zenitheesc/ZenSat-V3-EPS/README.md

<h1 align="center" style="color:white; background-color:black">ZenSat V3</h1>
<h4 align="center">Projeto de um CubeSat 2U para a competição Cube Design</h4>

<p align="center">
	<a href="http://zenith.eesc.usp.br/">
    
    </a>
    <a href="https://eesc.usp.br/">
    
    </a>
    <a href="https://github.com/${{ env.REPOSITORY_FULL_NAME }}/blob/main/LICENSE">
    
    </a>
    <a href="https://github.com/${{ env.REPOSITORY_FULL_NAME }}/issues">
    
    </a>
    <a href="https://github.com/${{ env.REPOSITORY_FULL_NAME }}/commits/main">
    
    </a>
    <a href="https://github.com/${{ env.REPOSITORY_FULL_NAME }}/graphs/contributors">
    
    </a>
    <a href="https://github.com/${{ env.REPOSITORY_FULL_NAME }}/commits/main">
    
    </a>
    <a href="https://github.com/${{ env.REPOSITORY_FULL_NAME }}/issues">
    
    </a>
    <a href="https://github.com/${{ env.REPOSITORY_FULL_NAME }}/pulls">
    
    </a>
</p>

<p align="center">
    <a href="#environment-and-tools">Environment and Tools</a> •
    <a href="#steps-to-run-and-debug">Steps to run and debug</a> •
    <a href="#how-to-contribute">How to contribute?</a> •
</p>

## Environment and tools

`Add list of dependencies and software needed to run this project (if possible add the versions that were used in development).`

## Steps to run and debug

`A simple list of steps indicating how one can run and test the project.`

## How to contribute

`(optional, depends on the project) list of simple rules to help people work on the project.`

`Examples: How to format a pull request\n How to format an issue`

---

<p align="center">
    <a href="http://zenith.eesc.usp.br">
    
    </a> 
    <a href="https://www.facebook.com/zenitheesc">
    
    </a> 
    <a href="https://www.instagram.com/zenith_eesc/">
    
    </a>

</p>
<p align = "center">
<a href="zenith.eesc@gmail.com">zenith.eesc@gmail.com</a>
</p>
