zenitheesc/ZenSat-V3-EPS/Main Board/BOM.csv

Reference | Qty | Value | DNP | Exclude from BOM | Exclude from Board | Footprint
C1,C2,C3,C4,C5,C6,C15,C22,C33 | 9 | 100nF |  |  |  | Capacitor_SMD:C_0402_1005Metric_Pad0.74x0.62mm_HandSolder
C7 | 1 | 1u |  |  |  | Capacitor_SMD:C_0402_1005Metric_Pad0.74x0.62mm_HandSolder
C10,C11 | 2 | 7p |  |  |  | Capacitor_SMD:C_0402_1005Metric_Pad0.74x0.62mm_HandSolder
C12,C14 | 2 | 33p |  |  |  | Capacitor_SMD:C_0402_1005Metric_Pad0.74x0.62mm_HandSolder
C13 | 1 | 4n7 |  |  |  | Capacitor_SMD:C_0402_1005Metric_Pad0.74x0.62mm_HandSolder
C16,C23,C37 | 3 | 10uF |  |  |  | Capacitor_SMD:C_0805_2012Metric_Pad1.18x1.45mm_HandSolder
C17,C18,C19,C20,C24,C25,C26,C27 | 8 | 22uF |  |  |  | Capacitor_SMD:C_1206_3216Metric_Pad1.33x1.80mm_HandSolder
C21,C28,C36 | 3 | 1uF |  |  |  | Capacitor_SMD:C_0603_1608Metric_Pad1.08x0.95mm_HandSolder
C29 | 1 | 100nF 25V |  |  |  | Capacitor_SMD:C_0402_1005Metric_Pad0.74x0.62mm_HandSolder
C30 | 1 | 10uF 10V |  |  |  | Capacitor_SMD:C_0805_2012Metric_Pad1.18x1.45mm_HandSolder
C31,C32,C34,C35 | 4 | 100nF 10V |  |  |  | Capacitor_SMD:C_0402_1005Metric_Pad0.74x0.62mm_HandSolder
C38 | 1 | 1uF 50V |  |  |  | Capacitor_SMD:C_0603_1608Metric_Pad1.08x0.95mm_HandSolder
C39 | 1 | 10uF 25V |  |  |  | Capacitor_SMD:C_1206_3216Metric_Pad1.33x1.80mm_HandSolder
C40 | 1 | 680nF |  |  |  | Capacitor_SMD:C_0402_1005Metric_Pad0.74x0.62mm_HandSolder
C41,C42 | 2 | 220nF |  |  |  | Capacitor_SMD:C_0402_1005Metric_Pad0.74x0.62mm_HandSolder
D1,D2,D3,D5,D6 | 5 | 1N5819HW |  |  |  | Diode_SMD:D_SOD-123
D4 | 1 | SS34 |  |  |  | Diode_SMD:D_SMA
D7,D8 | 2 | LEDG |  |  |  | LED_SMD:LED_0805_2012Metric_Pad1.15x1.40mm_HandSolder
D9 | 1 | LEDR |  |  |  | LED_SMD:LED_0805_2012Metric_Pad1.15x1.40mm_HandSolder
J1 | 1 | BatBus |  |  |  | Connector_PinHeader_2.54mm:PinHeader_2x06_P2.54mm_Vertical
J2 | 1 | ZenBus |  |  |  | Connector_PinHeader_2.54mm:PinHeader_2x20_P2.54mm_Vertical
J3 | 1 | Programmer |  |  |  | Connector_Molex:Molex_PicoBlade_53261-1071_1x10-1MP_P1.25mm_Horizontal
J4,J5,J6,J7 | 4 | Conn_01x02_Pin |  |  |  | Connector_JST:JST_ZH_B2B-ZR_1x02_P1.50mm_Vertical
J8 | 1 | External Power |  |  |  | Connector_Molex:Molex_PicoBlade_53261-0671_1x06-1MP_P1.25mm_Horizontal
JP1 | 1 | BOOT |  |  |  | Jumper:SolderJumper-3_P1.3mm_Open_RoundedPad1.0x1.5mm_NumberLabels
L1 | 1 | 6,8uH |  |  |  | Inductor_SMD:L_Sumida_CDMC6D28_7.25x6.5mm
L2 | 1 | 8uH |  |  |  | Inductor_SMD:L_Sumida_CDMC6D28_7.25x6.5mm
L3 | 1 | 47uH |  |  |  | Inductor_SMD:L_TDK_SLF7032
R1,R2,R4,R5,R10,R14,R19,R22,R23,R24,R25,R48,R51 | 13 | 10k |  |  |  | Resistor_SMD:R_0402_1005Metric_Pad0.72x0.64mm_HandSolder
R6,R7 | 2 | 4k7 |  |  |  | Resistor_SMD:R_0402_1005Metric_Pad0.72x0.64mm_HandSolder
R8,R9 | 2 | 60 |  |  |  | Resistor_SMD:R_0603_1608Metric_Pad0.98x0.95mm_HandSolder
R11,R16 | 2 | R05 |  |  |  | Resistor_SMD:R_0612_1632Metric_Pad1.18x3.40mm_HandSolder
R12,R17 | 2 | 100k |  |  |  | Resistor_SMD:R_0402_1005Metric_Pad0.72x0.64mm_HandSolder
R13 | 1 | 43,2k |  |  |  | Resistor_SMD:R_0402_1005Metric_Pad0.72x0.64mm_HandSolder
R15,R43,R47 | 3 | 1k |  |  |  | Resistor_SMD:R_0402_1005Metric_Pad0.72x0.64mm_HandSolder
R18 | 1 | 14,9k |  |  |  | Resistor_SMD:R_0402_1005Metric_Pad0.72x0.64mm_HandSolder
R28,R33,R34,R35,R37,R39,R41 | 7 | 0R |  |  |  | Resistor_SMD:R_0402_1005Metric_Pad0.72x0.64mm_HandSolder
R38,R42 | 2 | 0R33 |  |  |  | Resistor_SMD:R_1210_3225Metric_Pad1.30x2.65mm_HandSolder
R40 | 1 | 233k |  |  |  | Resistor_SMD:R_0402_1005Metric_Pad0.72x0.64mm_HandSolder
R44 | 1 | 25,2k |  |  |  | Resistor_SMD:R_0402_1005Metric_Pad0.72x0.64mm_HandSolder
R45 | 1 | 626k |  |  |  | Resistor_SMD:R_0402_1005Metric_Pad0.72x0.64mm_HandSolder
R46 | 1 | 412k |  |  |  | Resistor_SMD:R_0402_1005Metric_Pad0.72x0.64mm_HandSolder
R49,R50 | 2 | 470R |  |  |  | Resistor_SMD:R_0402_1005Metric_Pad0.72x0.64mm_HandSolder
S1 | 1 | RST |  |  |  | Button_Switch_SMD:SW_Push_1P1T_NO_CK_KMR2
U1 | 1 | STM32L476RGTx |  |  |  | Package_QFP:LQFP-64_10x10mm_P0.5mm
U2 | 1 | SN65HVD233 |  |  |  | Package_SO:SOIC-8_3.9x4.9mm_P1.27mm
U3,U4 | 2 | LMR33630ADDA |  |  |  | Package_SO:Texas_HSOP-8-1EP_3.9x4.9mm_P1.27mm_ThermalVias
U5 | 1 | AMS1117-3.3 |  |  |  | Package_TO_SOT_SMD:SOT-223-3_TabPin2
U6 | 1 | LM75B |  |  |  | Package_SO:Texas_S-PDSO-G8_3x3mm_P0.65mm
U7 | 1 | INA3221 |  |  |  | Package_DFN_QFN:Texas_RGV0016A_VQFN-16-1EP_4x4mm_P0.65mm_EP2.1x2.1mm
U8 | 1 | LM234DT |  |  |  | Package_SO:SOIC-8_3.9x4.9mm_P1.27mm
U9 | 1 | LT3652IMSE |  |  |  | Package_SO:MSOP-12-1EP_3x4.039mm_P0.65mm_EP1.651x2.845mm_ThermalVias
Y1 | 1 | 32,768k |  |  |  | Crystal:Crystal_SMD_3215-2Pin_3.2x1.5mm
