zenitheesc/ZenSat-V3-EPS/Main Board/Kicad/production/bom.csv

Designator | Footprint | Quantity | Value | LCSC Part #
C1, C15, C2, C22, C3, C33, C4, C5, C6 | 0402 | 9 | 100nF
C10, C11 | 0402 | 2 | 7p
C12, C14 | 0402 | 2 | 33p
C13 | 0402 | 1 | 4n7
C16, C23, C37 | 0805 | 3 | 10uF
C17, C18, C19, C20, C24, C25, C26, C27 | 1206 | 8 | 22uF
C21, C28, C36 | 0603 | 3 | 1uF
C29 | 0402 | 1 | 100nF 25V
C30 | 0805 | 1 | 10uF 10V
C31, C32, C34, C35 | 0402 | 4 | 100nF 10V
C38 | 0603 | 1 | 1uF 50V
C39 | 1206 | 1 | 10uF 25V
C40 | 0402 | 1 | 680nF
C41, C42 | 0402 | 2 | 220nF
C7 | 0402 | 1 | 1u
D1, D2, D3, D5, D6 | D_SOD-123 | 5 | 1N5819HW
D4 | D_SMA | 1 | SS34
D7, D8 | 0805 | 2 | LEDG
D9 | 0805 | 1 | LEDR
J1 | PinHeader_2x06_P2.54mm_Vertical | 1 | BatBus
J2 | PinHeader_2x20_P2.54mm_Vertical | 1 | ZenBus
J3 | Molex_PicoBlade_53261-1071_1x10-1MP_P1.25mm_Horizontal | 1 | Programmer
J4, J5, J6, J7 | JST_ZH_B2B-ZR_1x02_P1.50mm_Vertical | 4 | Conn_01x02_Pin
J8 | Molex_PicoBlade_53261-0671_1x06-1MP_P1.25mm_Horizontal | 1 | External Power
JP1 | SolderJumper-3_P1.3mm_Open_RoundedPad1.0x1.5mm_NumberLabels | 1 | BOOT
L1 | L_Sumida_CDMC6D28_7.25x6.5mm | 1 | 6,8uH
L2 | L_Sumida_CDMC6D28_7.25x6.5mm | 1 | 8uH
L3 | L_TDK_SLF7032 | 1 | 47uH
R1, R10, R14, R19, R2, R22, R23, R24, R25, R4, R48, R5, R51 | 0402 | 13 | 10k
R11, R16 | 0612 | 2 | R05
R12, R17 | 0402 | 2 | 100k
R13 | 0402 | 1 | 43,2k
R15, R43, R47 | 0402 | 3 | 1k
R18 | 0402 | 1 | 14,9k
R28, R33, R34, R35, R37, R39, R41 | 0402 | 7 | 0R
R38, R42 | 1210 | 2 | 0R33
R40 | 0402 | 1 | 233k
R44 | 0402 | 1 | 25,2k
R45 | 0402 | 1 | 626k
R46 | 0402 | 1 | 412k
R49, R50 | 0402 | 2 | 470R
R6, R7 | 0402 | 2 | 4k7
R8, R9 | 0603 | 2 | 60
S1 | SW_Push_1P1T_NO_CK_KMR2 | 1 | RST
U1 | LQFP-64_10x10mm_P0.5mm | 1 | STM32L476RGTx
U2 | SOIC-8_3.9x4.9mm_P1.27mm | 1 | SN65HVD233
U3, U4 | Texas_HSOP-8-1EP_3.9x4.9mm_P1.27mm_ThermalVias | 2 | LMR33630ADDA
U5 | SOT-223-3_TabPin2 | 1 | AMS1117-3.3
U6 | Texas_S-PDSO-G8_3x3mm_P0.65mm | 1 | LM75B
U7 | Texas_RGV0016A_VQFN-16-1EP_4x4mm_P0.65mm_EP2.1x2.1mm | 1 | INA3221
U8 | SOIC-8_3.9x4.9mm_P1.27mm | 1 | LM234DT
U9 | MSOP-12-1EP_3x4.039mm_P0.65mm_EP1.651x2.845mm_ThermalVias | 1 | LT3652IMSE
Y1 | Crystal_SMD_3215-2Pin_3.2x1.5mm | 1 | 32,768k
