zenitheesc/ZenSat-V3-EPS/PCB Baterias/Kicad/production/bom.csv

Designator | Footprint | Quantity | Value | LCSC Part #
B1 | PinHeader_2x06_P2.54mm_Vertical_SMD | 1 | BatBus
C1, C2, C3, C4, C5 | 0402 | 5 | 100nF 10V
C6, C7 | 0402 | 2 | 100n
C8 | 0805 | 1 | 10uF 10V
J1 | Molex_KK-254_AE-6410-02A_1x02_P2.54mm_Vertical | 1 | Conn_Deploy
J10, J3, J4, J5, J6, J7, J8, J9 | BatteryClip_Keystone_54_D16-19mm | 8 | 18650 Socket
J2 | PinHeader_1x02_P2.54mm_Vertical | 1 | PwrON
Q1, Q2, Q3, Q4 | SOIC-8_3.9x4.9mm_P1.27mm | 4 | Si4162DY
R12 | 0402 | 1 | 0R
R15, R16, R17 | R_Axial_DIN0516_L15.5mm_D5.0mm_P30.48mm_Horizontal | 3 | 100R
R21, R26 | 0402 | 2 | 330R
R22, R23 | 0402 | 2 | 10R
R24, R25 | 0402 | 2 | 10K
R27 | 0402 | 1 | 2k
TH1 | R_Axial_DIN0204_L3.6mm_D1.6mm_P1.90mm_Vertical | 1 | Thermistor_NTC
U1 | Texas_RGV0016A_VQFN-16-1EP_4x4mm_P0.65mm_EP2.1x2.1mm | 1 | INA3221
U2 | MSOP-8_3x3mm_P0.65mm | 1 | MCP9808
U3 | SOT-23-6 | 1 | FM7021DB
