zenitheesc/ZenSat-V3-EPS/PCB Baterias/Esquema.pdf

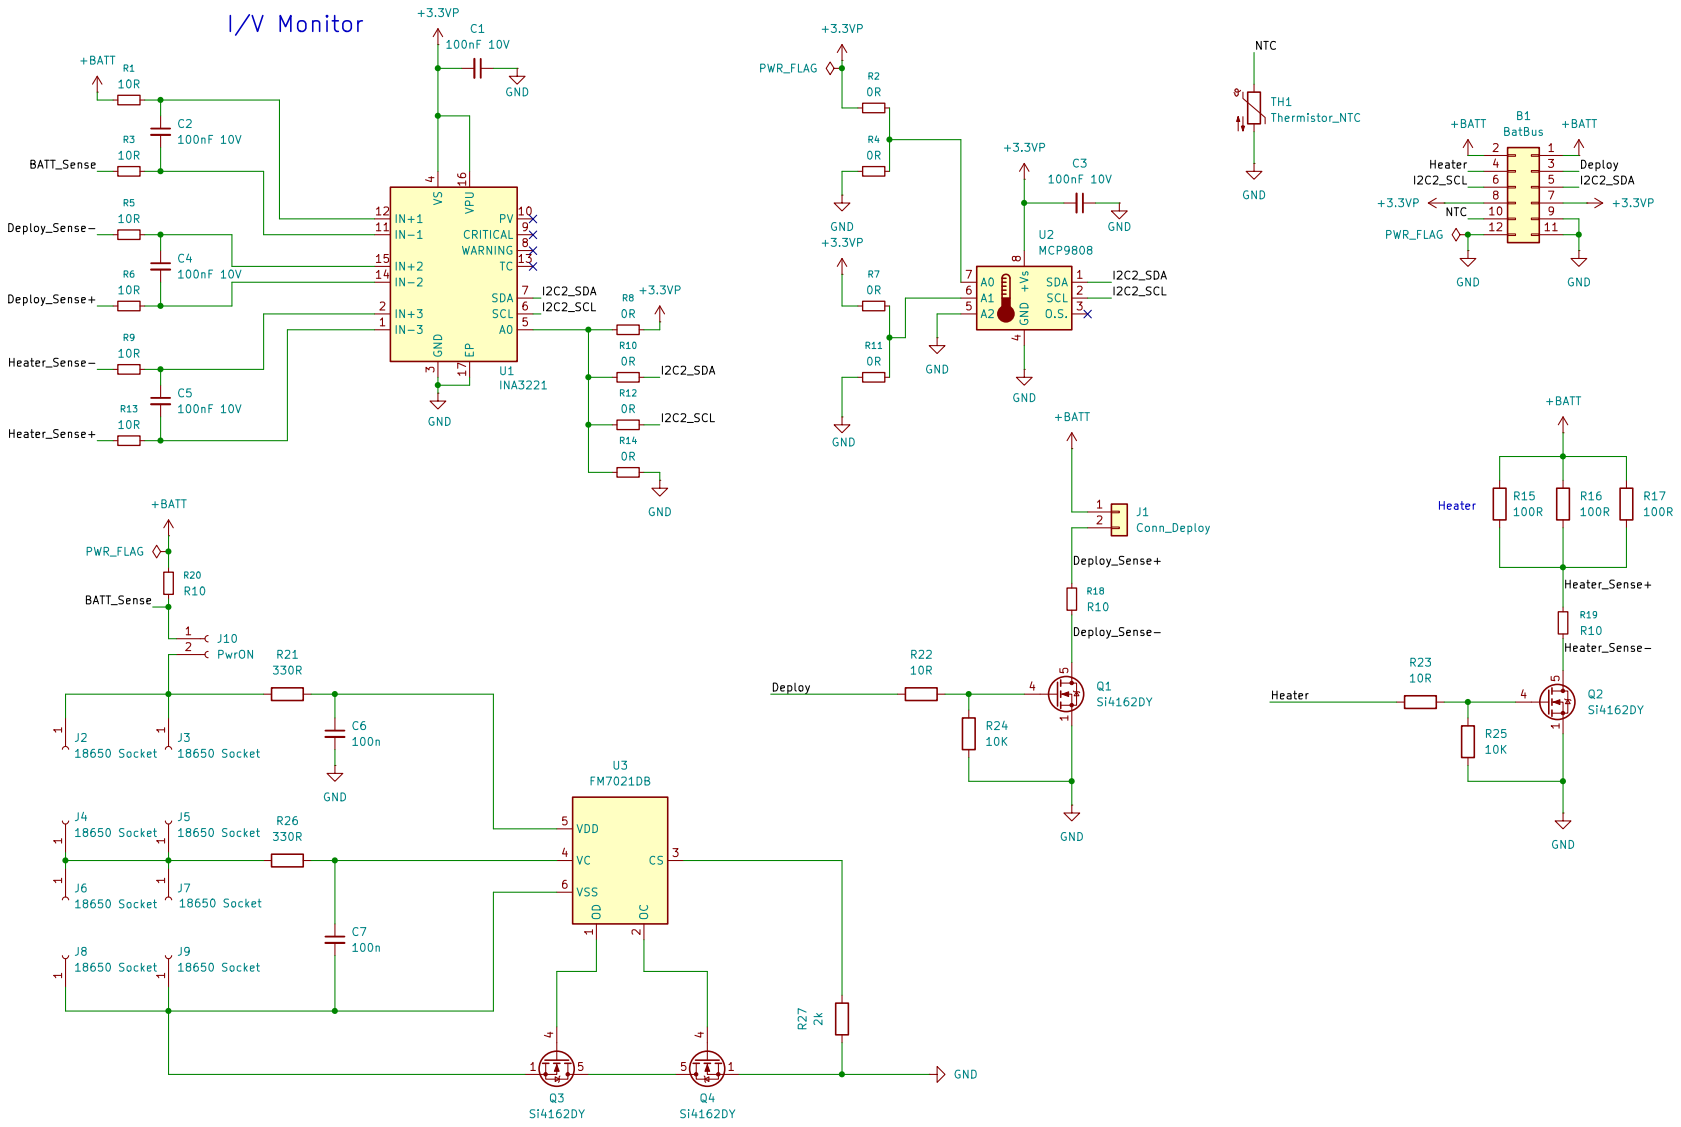
[picture p1: page 1]
