zenitheesc/ZenSat-V3-EPS/Main Board/Esquema.pdf

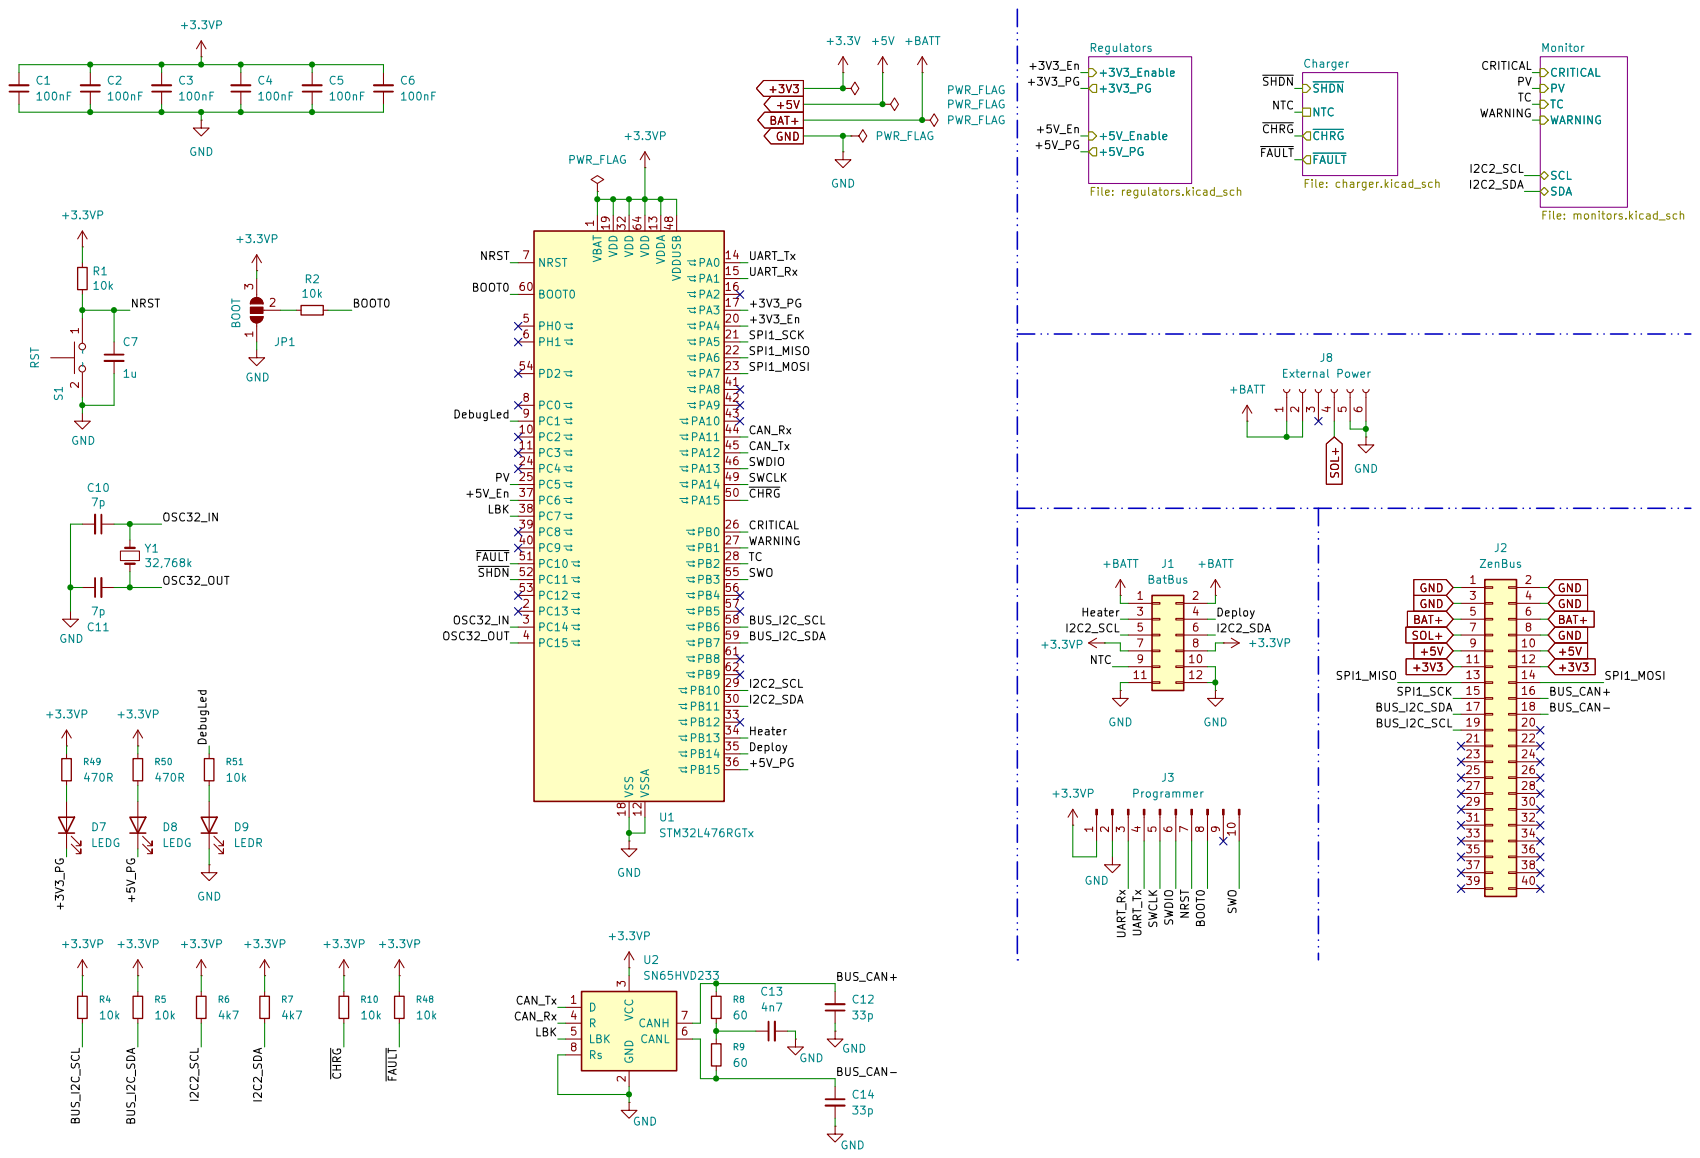
[picture p7: page 1]

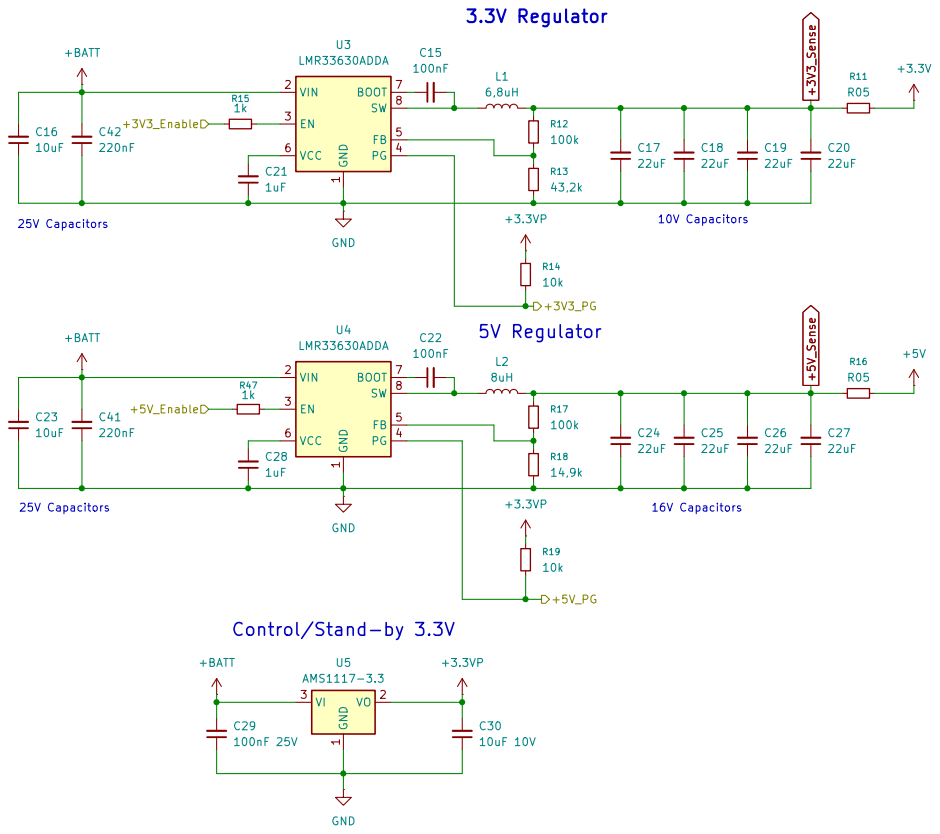
[picture p8: page 2]

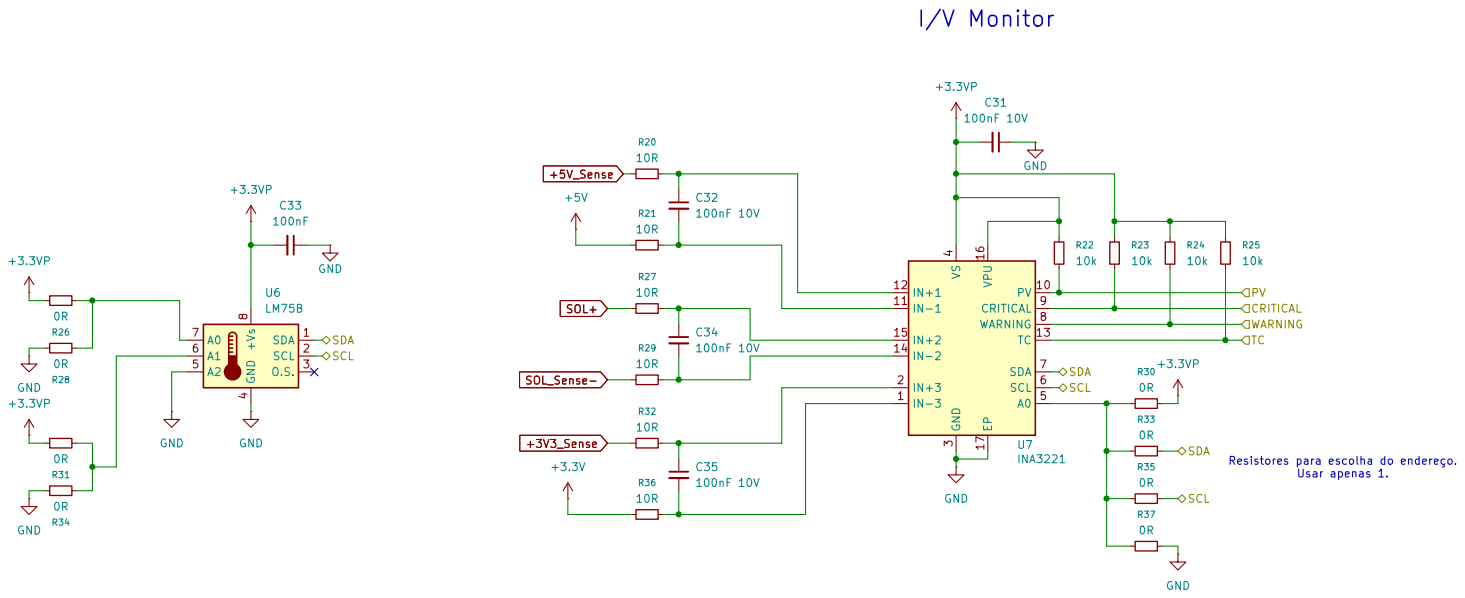
[picture p9: page 3]

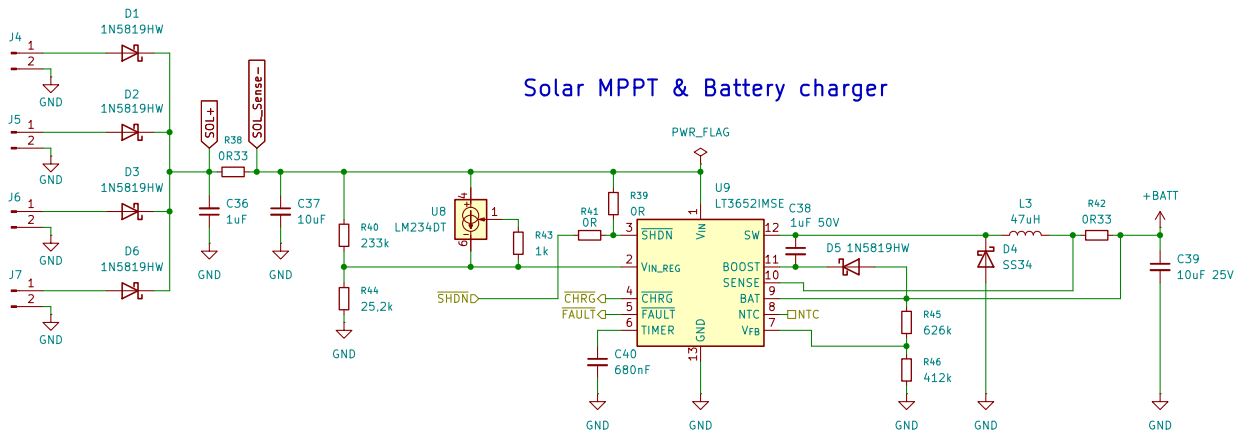
[picture p10: page 4]
