zenitheesc/ZenSat-V3-EPS/Simulações/LT3652.asc

C1: cap; .2m
C2: cap; 1µ
C3: cap; 10µ
D1: schottky; 1N5817
D2: schottky; MBRS340
L1: ind; 6.8µ; Rpar=10K
R1: res; 50m
R2: res; 300k
R3: res; 100k
R4: res; 100
U1: LT3652
V1: voltage; 16; Rser=100
Named nets: 0, IN, OUT
.tran 30m startup
