zenitheesc/ZenSat-V3-EPS/Main Board/Kicad/Power Supply ZensatV3.kicad_pcb

## KiCad design Main Board/Kicad/Power Supply ZensatV3.kicad_pcb (2026-10-23)

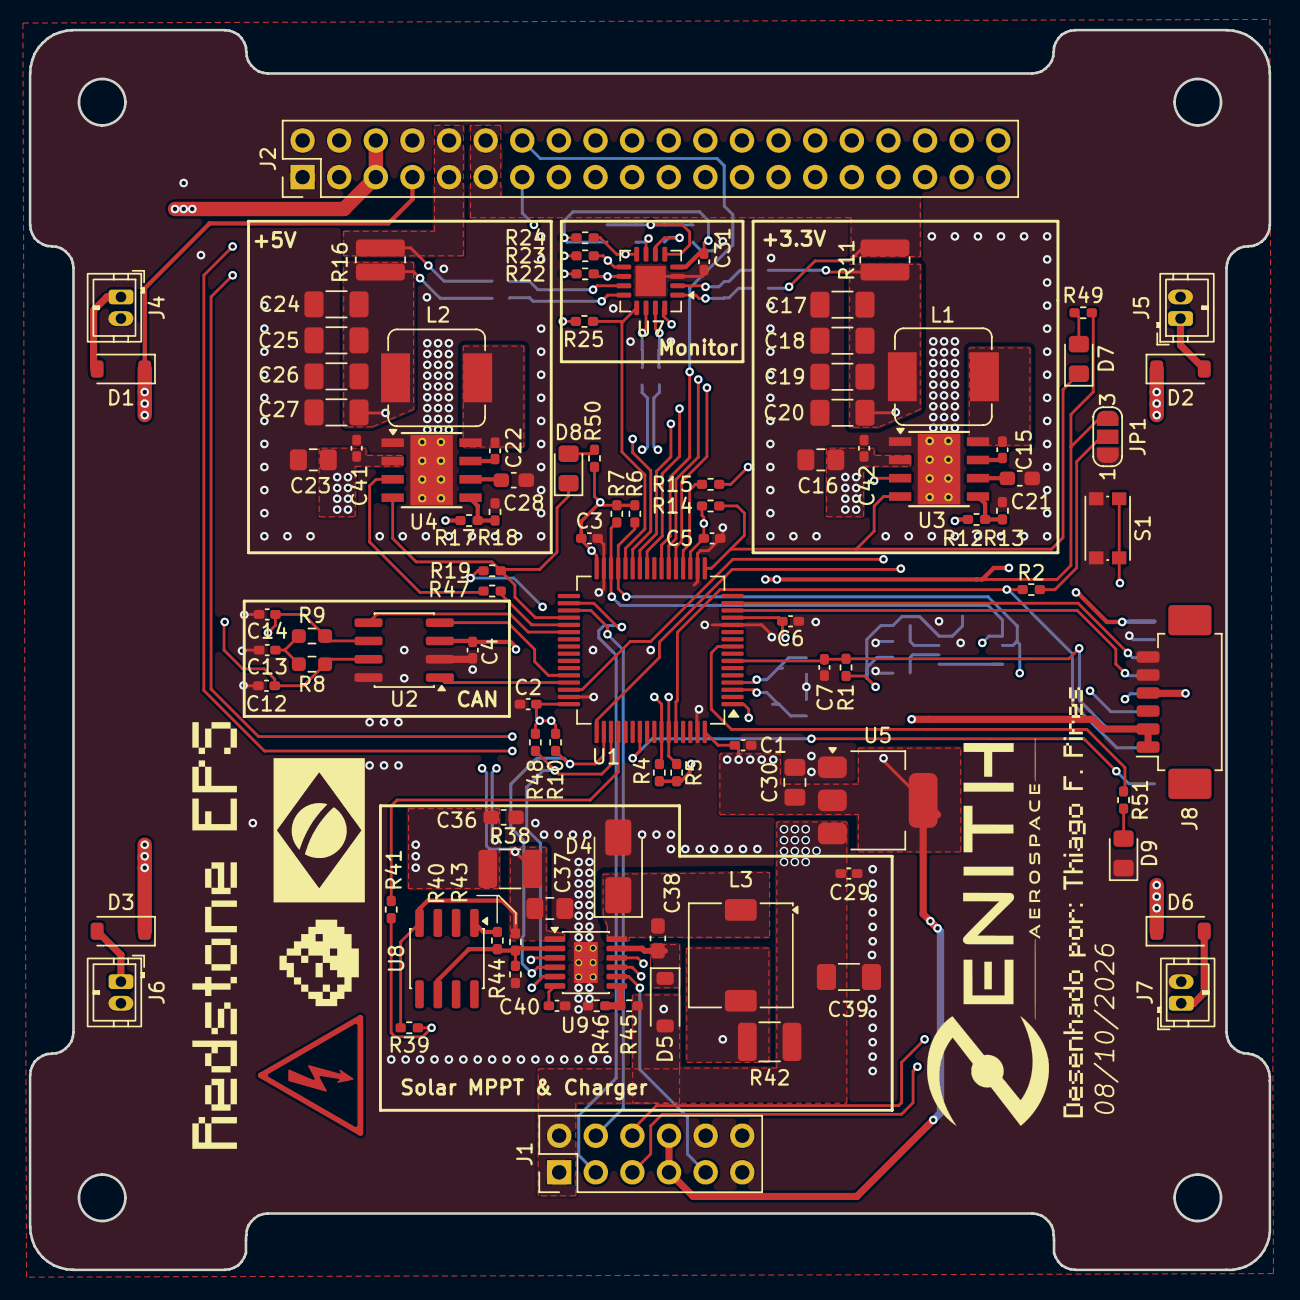
[picture p11: board Main Board/Kicad/Power Supply ZensatV3.kicad_pcb from above]

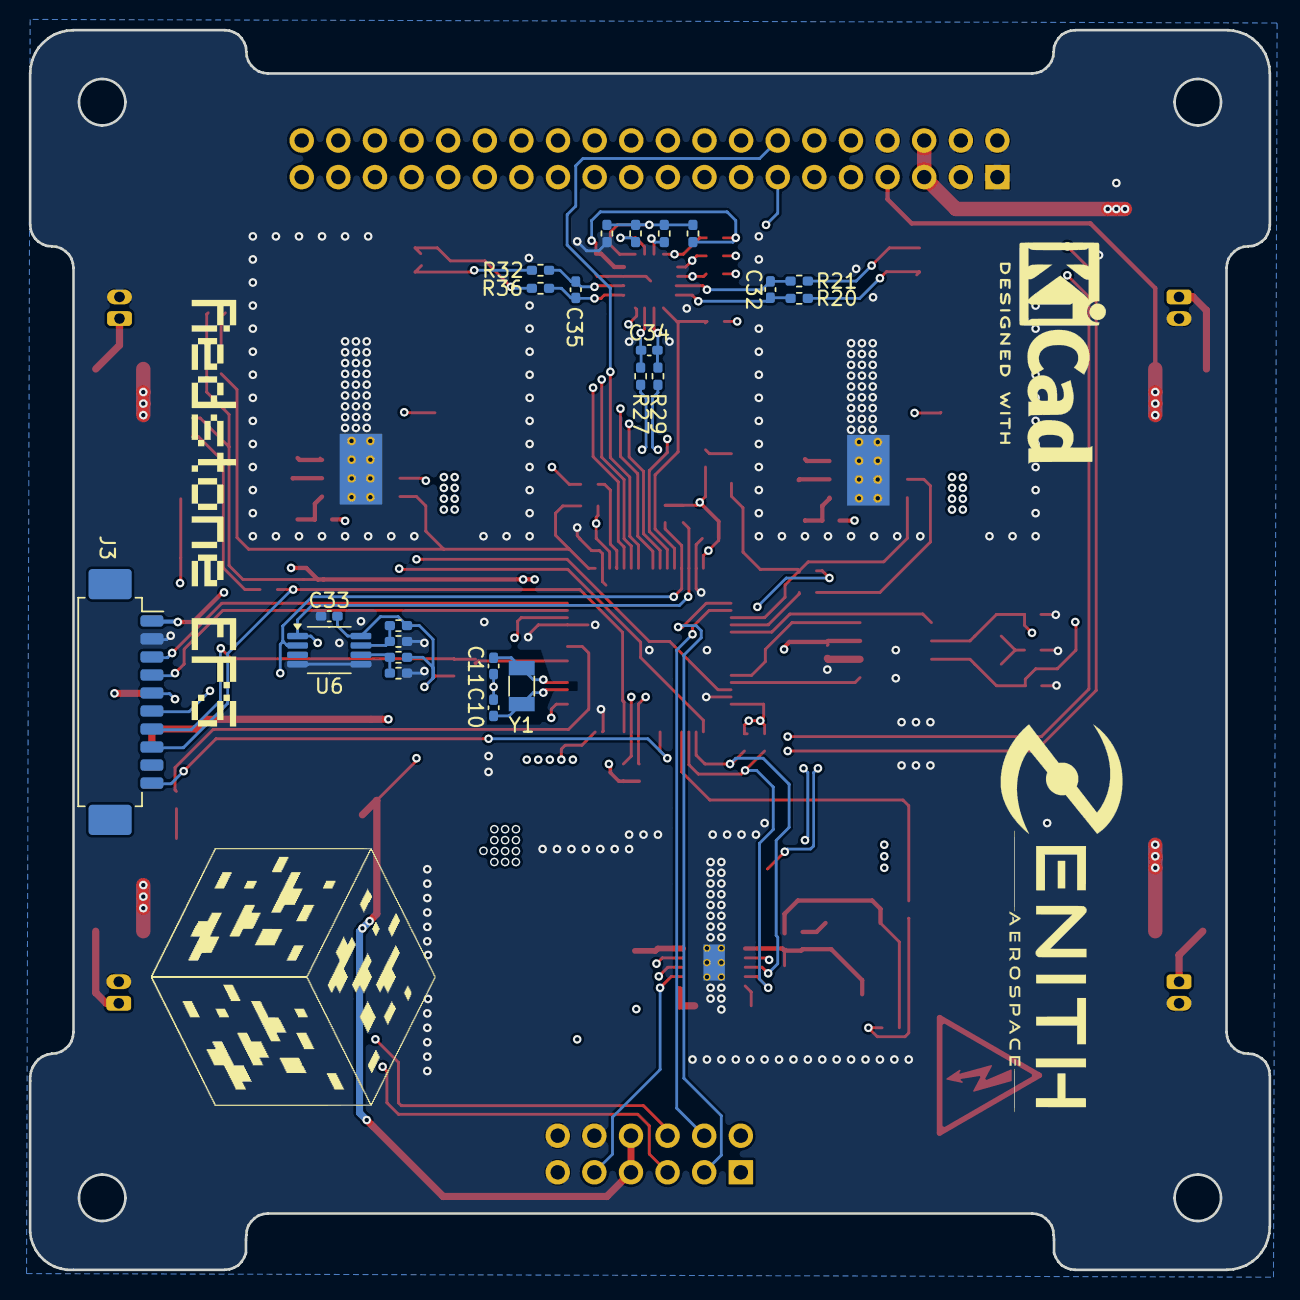
[picture p12: board Main Board/Kicad/Power Supply ZensatV3.kicad_pcb from below]

Board: 4 copper layers, 86.0 x 86.0 mm, 122 parts (23 on the bottom side), 81 nets.

Parts:
C1, C2, C3, C4, C5, C6, C15, C22, C33: 100nF; C_0402_1005Metric_Pad0.74x0.62mm_HandSolder
C7: 1u; C_0402_1005Metric_Pad0.74x0.62mm_HandSolder
C10, C11: 7p; C_0402_1005Metric_Pad0.74x0.62mm_HandSolder
C12, C14: 33p; C_0402_1005Metric_Pad0.74x0.62mm_HandSolder
C13: 4n7; C_0402_1005Metric_Pad0.74x0.62mm_HandSolder
C16, C23, C37: 10uF; C_0805_2012Metric_Pad1.18x1.45mm_HandSolder
C17, C18, C19, C20, C24, C25, C26, C27: 22uF; C_1206_3216Metric_Pad1.33x1.80mm_HandSolder
C21, C28, C36: 1uF; C_0603_1608Metric_Pad1.08x0.95mm_HandSolder
C29: 100nF 25V; C_0402_1005Metric_Pad0.74x0.62mm_HandSolder
C30: 10uF 10V; C_0805_2012Metric_Pad1.18x1.45mm_HandSolder
C31, C32, C34, C35: 100nF 10V; C_0402_1005Metric_Pad0.74x0.62mm_HandSolder
C38: 1uF 50V; C_0603_1608Metric_Pad1.08x0.95mm_HandSolder
C39: 10uF 25V; C_1206_3216Metric_Pad1.33x1.80mm_HandSolder
C40: 680nF; C_0402_1005Metric_Pad0.74x0.62mm_HandSolder
C41, C42: 220nF; C_0402_1005Metric_Pad0.74x0.62mm_HandSolder
D1, D2, D3, D5, D6: 1N5819HW; D_SOD-123
D4: SS34; D_SMA
D7, D8: LEDG; LED_0805_2012Metric_Pad1.15x1.40mm_HandSolder
D9: LEDR; LED_0805_2012Metric_Pad1.15x1.40mm_HandSolder
J1: BatBus; PinHeader_2x06_P2.54mm_Vertical
J2: ZenBus; PinHeader_2x20_P2.54mm_Vertical
J3: Programmer; Molex_PicoBlade_53261-1071_1x10-1MP_P1.25mm_Horizontal
J4, J5, J6, J7: Conn_01x02_Pin; JST_ZH_B2B-ZR_1x02_P1.50mm_Vertical
J8: External Power; Molex_PicoBlade_53261-0671_1x06-1MP_P1.25mm_Horizontal
JP1: BOOT; SolderJumper-3_P1.3mm_Open_RoundedPad1.0x1.5mm_NumberLabels
L1: 6,8uH; L_Sumida_CDMC6D28_7.25x6.5mm
L2: 8uH; L_Sumida_CDMC6D28_7.25x6.5mm
L3: 47uH; L_TDK_SLF7032
R1, R2, R4, R5, R10, R14, R19, R22, R23, R24, R25, R48, R51: 10k; R_0402_1005Metric_Pad0.72x0.64mm_HandSolder
R6, R7: 4k7; R_0402_1005Metric_Pad0.72x0.64mm_HandSolder
R8, R9: 60; R_0603_1608Metric_Pad0.98x0.95mm_HandSolder
R11, R16: R05; R_0612_1632Metric_Pad1.18x3.40mm_HandSolder
R12, R17: 100k; R_0402_1005Metric_Pad0.72x0.64mm_HandSolder
R13: 43,2k; R_0402_1005Metric_Pad0.72x0.64mm_HandSolder
R15, R43, R47: 1k; R_0402_1005Metric_Pad0.72x0.64mm_HandSolder
R18: 14,9k; R_0402_1005Metric_Pad0.72x0.64mm_HandSolder
R20, R21, R27, R29, R32, R36: 10R; R_0402_1005Metric_Pad0.72x0.64mm_HandSolder
R26, R28, R30, R31, R33, R34, R35, R37, R39, R41: 0R; R_0402_1005Metric_Pad0.72x0.64mm_HandSolder
R38, R42: 0R33; R_1210_3225Metric_Pad1.30x2.65mm_HandSolder
R40: 233k; R_0402_1005Metric_Pad0.72x0.64mm_HandSolder
R44: 25,2k; R_0402_1005Metric_Pad0.72x0.64mm_HandSolder
R45: 626k; R_0402_1005Metric_Pad0.72x0.64mm_HandSolder
R46: 412k; R_0402_1005Metric_Pad0.72x0.64mm_HandSolder
R49, R50: 470R; R_0402_1005Metric_Pad0.72x0.64mm_HandSolder
S1: RST; SW_Push_1P1T_NO_CK_KMR2
U1: STM32L476RGTx; LQFP-64_10x10mm_P0.5mm
U2: SN65HVD233; SOIC-8_3.9x4.9mm_P1.27mm
U3, U4: LMR33630ADDA; Texas_HSOP-8-1EP_3.9x4.9mm_P1.27mm_ThermalVias
U5: AMS1117-3.3; SOT-223-3_TabPin2
U6: LM75B; Texas_S-PDSO-G8_3x3mm_P0.65mm
U7: INA3221; Texas_RGV0016A_VQFN-16-1EP_4x4mm_P0.65mm_EP2.1x2.1mm
U8: LM234DT; SOIC-8_3.9x4.9mm_P1.27mm
U9: LT3652IMSE; MSOP-12-1EP_3x4.039mm_P0.65mm_EP1.651x2.845mm_ThermalVias
Y1: 32,768k; Crystal_SMD_3215-2Pin_3.2x1.5mm

Connections:
+3.3VP: C1.2, C2.2, C3.2, C4.2, C5.2, C6.2, C30.2, C31.2, C33.2, J1.7, J1.8, J3.1, JP1.3 (B), R1.1, R4.1, R5.1, R6.1, R7.1, R10.1, R14.1, R19.1, R22.2, R23.2, R24.2, R25.2, R26.1, R30.1, R31.1, R48.1, R49.1, R50.1, U1.1 (VBAT), U1.13 (VDDA), U1.19 (VDD), U1.32 (VDD), U1.48 (VDDUSB), U1.64 (VDD), U2.3 (VCC), U5.2 (VO), U6.8 (+Vs), U7.4 (VS), U7.16 (VPU)
+3V3: J2.11, J2.12, R11.2, R36.2
+3V3_Sense: C17.2, C18.2, C19.2, C20.2, L1.2, R11.1, R12.1, R32.2
+5V: J2.9, J2.10, R16.2, R21.2
+5V_Sense: C24.2, C25.2, C26.2, C27.2, L2.2, R16.1, R17.1, R20.2
/+3V3_En: R15.1, U1.20 (PA4)
/+3V3_PG: D7.1 (K), R14.2, U1.17 (PA3), U3.4 (PG)
/+5V_En: R47.1, U1.37 (PC6)
/+5V_PG: D8.1 (K), R19.2, U1.36 (PB15), U4.4 (PG)
/BOOT0: J3.8, R2.1, U1.60 (BOOT0)
/BUS_CAN+: C12.2, J2.16, R8.1, U2.7 (CANH)
/BUS_CAN-: C14.1, J2.18, R9.2, U2.6 (CANL)
/BUS_I2C_SCL: J2.19, R4.2, U1.58 (PB6)
/BUS_I2C_SDA: J2.17, R5.2, U1.59 (PB7)
/CAN_Rx: U1.44 (PA11), U2.4 (R)
/CAN_Tx: U1.45 (PA12), U2.1 (D)
/CRITICAL: R23.1, U1.26 (PB0), U7.9 (CRITICAL)
/DebugLed: R51.1, U1.9 (PC1)
/Deploy: J1.4, U1.35 (PB14)
/Heater: J1.3, U1.34 (PB13)
/I2C2_SCL: J1.5, R6.2, R35.1, U1.29 (PB10), U6.2 (SCL), U7.6 (SCL)
/I2C2_SDA: J1.6, R7.2, R33.1, U1.30 (PB11), U6.1 (SDA), U7.7 (SDA)
/LBK: U1.38 (PC7), U2.5 (LBK)
/NRST: C7.1, J3.7, R1.2, S1.1, U1.7 (NRST)
/NTC: J1.9, U9.8 (NTC)
/OSC32_IN: C10.1, U1.3 (PC14), Y1.2
/OSC32_OUT: C11.2, U1.4 (PC15), Y1.1
/PV: R22.1, U1.25 (PC5), U7.10 (PV)
/SPI1_MISO: J2.13, U1.22 (PA6)
/SPI1_MOSI: J2.14, U1.23 (PA7)
/SPI1_SCK: J2.15, U1.21 (PA5)
/SWCLK: J3.5, U1.49 (PA14)
/SWDIO: J3.6, U1.46 (PA13)
/SWO: J3.10, U1.55 (PB3)
/TC: R25.1, U1.28 (PB2), U7.13 (TC)
/UART_Rx: J3.3, U1.15 (PA1)
/UART_Tx: J3.4, U1.14 (PA0)
/WARNING: R24.1, U1.27 (PB1), U7.8 (WARNING)
/~CHRG: R10.2, U1.50 (PA15), U9.4 (~CHRG)
/~FAULT: R48.2, U1.51 (PC10), U9.5 (~FAULT)
/~SHDN: R41.1, U1.52 (PC11)
BAT+: C16.2, C23.2, C29.2, C39.1, C41.2, C42.2, D5.2 (A), J1.1, J1.2, J2.5, J2.6, J8.1, J8.2, R42.2, R45.2, U3.2 (VIN), U4.2 (VIN), U5.3 (VI), U9.9 (BAT)
GND: C1.1, C2.1, C3.1, C4.1, C5.1, C6.1, C7.2, C10.2, C11.1, C12.1, C13.2, C14.2, C16.1, C17.1, C18.1, C19.1, C20.1, C21.1, C23.1, C24.1, C25.1, C26.1, C27.1, C28.1, C29.1, C30.1, C31.1, C33.1, C36.1, C37.2, C39.2, C40.2, C41.1, C42.1, D4.2 (A), D9.1 (K), J1.10, J1.11, J1.12, J2.1, J2.2, J2.3, J2.4, J2.8, J3.2, J4.2, J5.2, J6.2, J7.2, J8.5, J8.6, JP1.1 (A), R13.2, R18.2, R28.1, R34.1, R37.1, R44.1, R46.1, S1.2, U1.12 (VSSA), U1.18 (VSS), U1.31 (VSS), U1.47 (VSS), U1.63 (VSS), U2.2 (GND), U2.8 (Rs), U3.1 (GND), U3.9 (GND), U4.1 (GND), U4.9 (GND), U5.1 (GND), U6.4 (GND), U6.5 (A2), U7.3 (GND), U7.17 (EP), U9.13 (GND)
unnamed: C13.1, R8.2, R9.1
unnamed: D1.2 (A), J4.1
unnamed: D2.2 (A), J5.1
unnamed: D3.2 (A), J6.1
unnamed: C38.1, D4.1 (K), L3.1, U9.12 (SW)
unnamed: C38.2, D5.1 (K), U9.11 (BOOST)
unnamed: D6.2 (A), J7.1
unnamed: D7.2 (A), R49.2
unnamed: D8.2 (A), R50.2
unnamed: D9.2 (A), R51.2
unnamed: JP1.2 (C), R2.2
unnamed: R43.2, U8.1
unnamed: C15.1, U3.7 (BOOT)
unnamed: R15.2, U3.3 (EN)
unnamed: R12.2, R13.1, U3.5 (FB)
unnamed: C15.2, L1.1, U3.8 (SW)
unnamed: C21.2, U3.6 (VCC)
unnamed: C22.1, U4.7 (BOOT)
unnamed: R47.2, U4.3 (EN)
unnamed: R17.2, R18.1, U4.5 (FB)
unnamed: C22.2, L2.1, U4.8 (SW)
unnamed: C28.2, U4.6 (VCC)
unnamed: R26.2, R28.2, U6.7 (A0)
unnamed: R31.2, R34.2, U6.6 (A1)
unnamed: R30.2, R33.2, R35.2, R37.2, U7.5 (A0)
unnamed: C32.1, R20.1, U7.12 (IN+1)
unnamed: C34.1, R27.1, U7.15 (IN+2)
unnamed: C35.1, R32.1, U7.2 (IN+3)
unnamed: C32.2, R21.1, U7.11 (IN-1)
unnamed: C34.2, R29.1, U7.14 (IN-2)
unnamed: C35.2, R36.1, U7.1 (IN-3)
unnamed: L3.2, R42.1, U9.10 (SENSE)
unnamed: C40.1, U9.6 (TIMER)
unnamed: R45.1, R46.2, U9.7 (V_{FB})
unnamed: R40.1, R43.1, R44.2, U8.6, U9.2 (V_{IN_REG})
unnamed: R39.1, R41.2, U9.3 (~SHDN)
SOL+: C36.2, D1.1 (K), D2.1 (K), D3.1 (K), D6.1 (K), J2.7, J8.4, R27.2, R38.1
SOL_Sense-: C37.1, R29.2, R38.2, R39.2, R40.2, U8.4, U9.1 (V_{IN})
