zenitheesc/ZenSat-V3-EPS/PCB Baterias/Kicad/PCB Bateria 09082026.kicad_pcb

## KiCad design PCB Baterias/Kicad/PCB Bateria 09082026.kicad_pcb (2026-10-23)

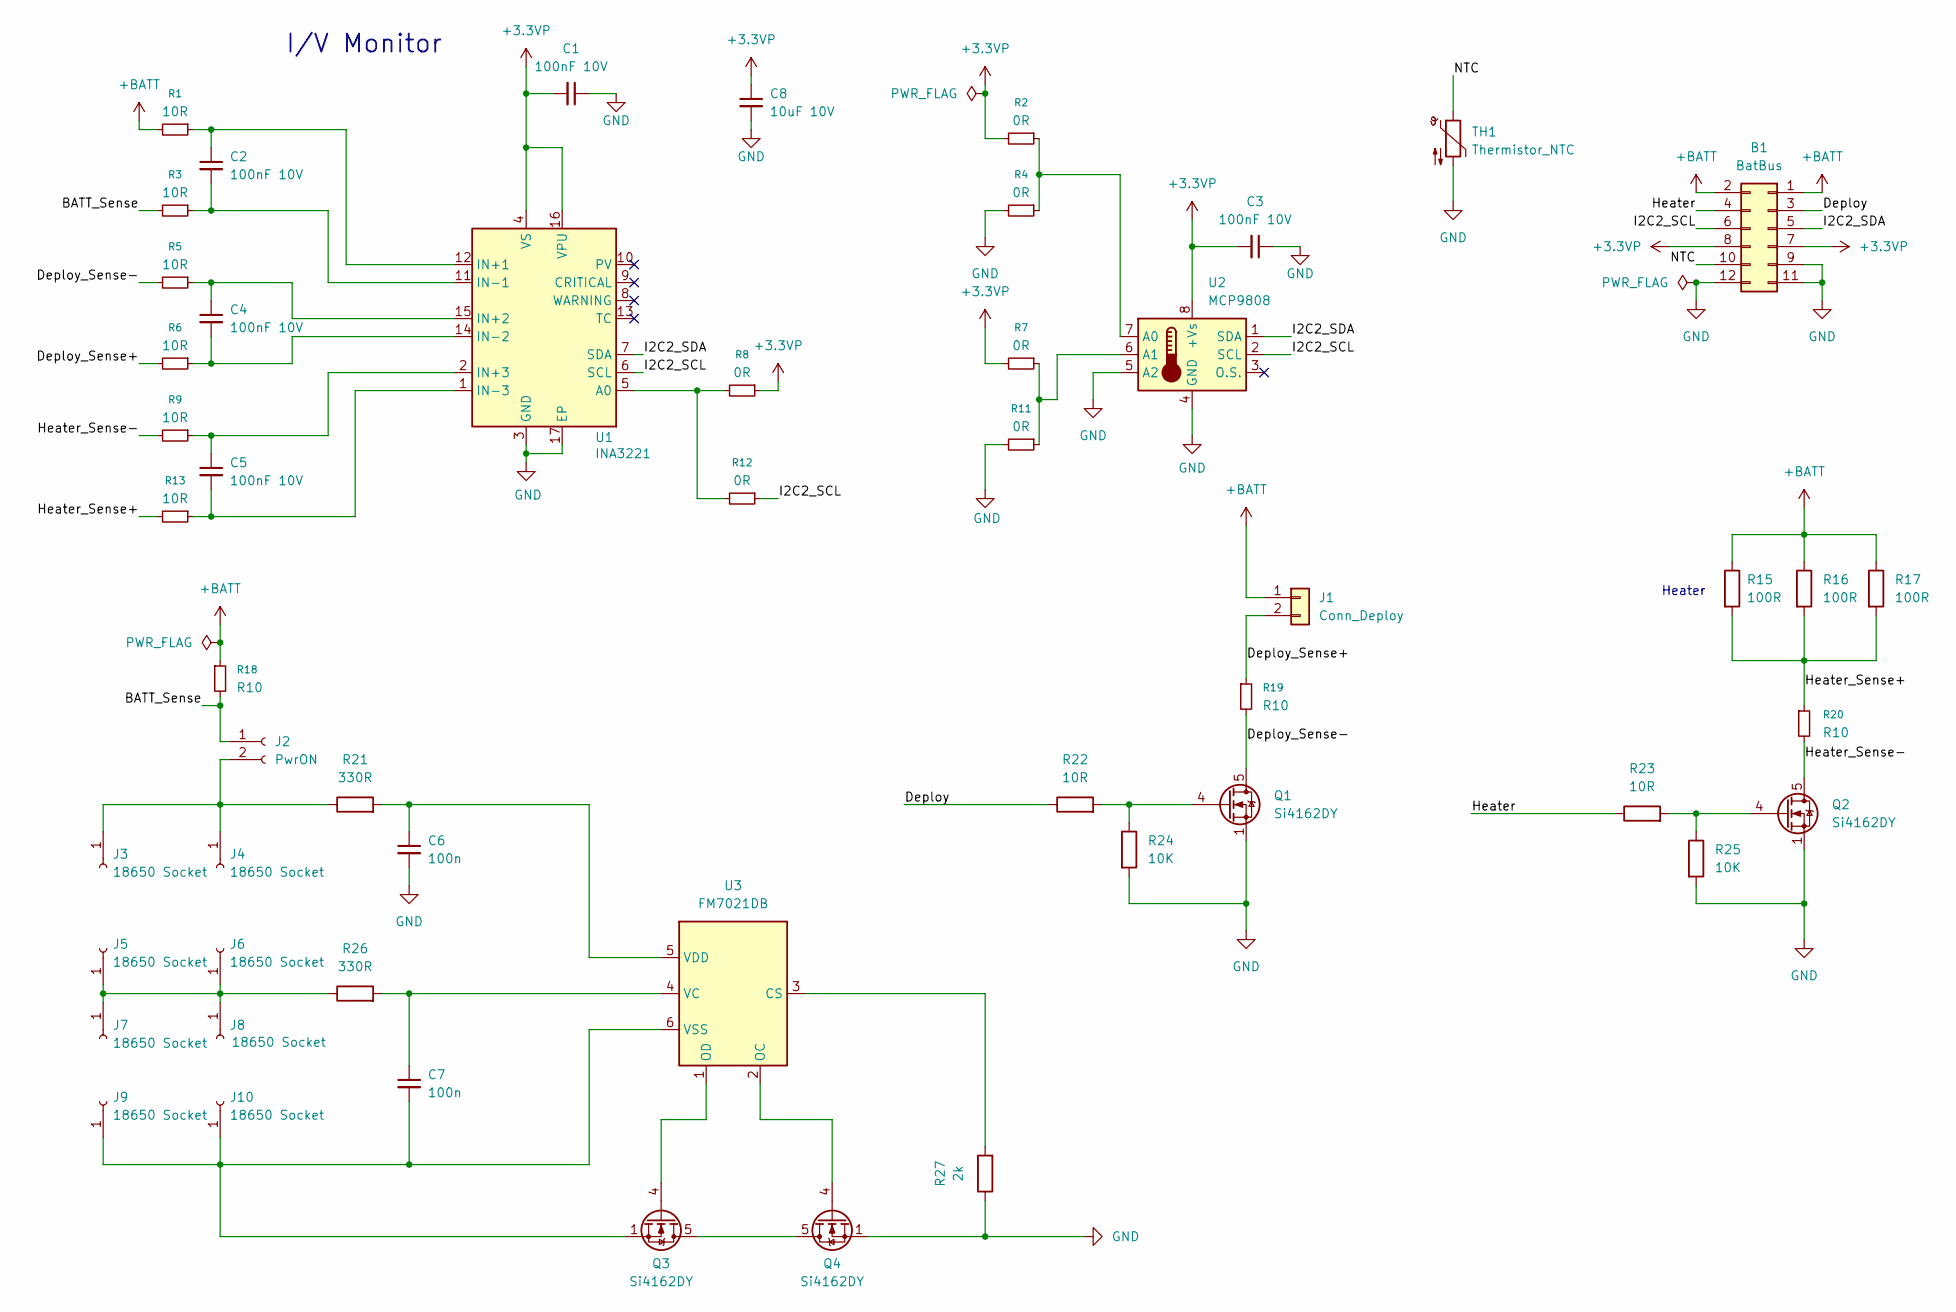
[picture p13: schematic PCB Bateria 09082026.kicad_sch]

Parts:
B1: BatBus; PinHeader_2x06_P2.54mm_Vertical_SMD
C1, C2, C3, C4, C5: 100nF 10V; C_0402_1005Metric_Pad0.74x0.62mm_HandSolder
C6, C7: 100n; C_0402_1005Metric_Pad0.74x0.62mm_HandSolder
C8: 10uF 10V; C_0805_2012Metric_Pad1.18x1.45mm_HandSolder
J1: Conn_Deploy; Molex_KK-254_AE-6410-02A_1x02_P2.54mm_Vertical
J2: PwrON; PinHeader_1x02_P2.54mm_Vertical
J3, J4, J5, J6, J7, J8, J9, J10: 18650 Socket; BatteryClip_Keystone_54_D16-19mm
Q1, Q2, Q3, Q4: Si4162DY; SOIC-8_3.9x4.9mm_P1.27mm
R1, R3, R5, R6, R9, R13, R22, R23: 10R; R_0402_1005Metric_Pad0.72x0.64mm_HandSolder
R2, R4, R7, R8, R11, R12: 0R; R_0402_1005Metric_Pad0.72x0.64mm_HandSolder
R15, R16, R17: 100R; R_Axial_DIN0516_L15.5mm_D5.0mm_P30.48mm_Horizontal
R18, R19, R20: R10; R_1206_3216Metric_Pad1.30x1.75mm_HandSolder
R21, R26: 330R; R_0402_1005Metric_Pad0.72x0.64mm_HandSolder
R24, R25: 10K; R_0402_1005Metric_Pad0.72x0.64mm_HandSolder
R27: 2k; R_0402_1005Metric_Pad0.72x0.64mm_HandSolder
TH1: Thermistor_NTC; R_Axial_DIN0204_L3.6mm_D1.6mm_P1.90mm_Vertical
U1: INA3221; Texas_RGV0016A_VQFN-16-1EP_4x4mm_P0.65mm_EP2.1x2.1mm
U2: MCP9808; MSOP-8_3x3mm_P0.65mm
U3: FM7021DB; SOT-23-6

Connections:
+3.3VP: B1.7, B1.8, C1.2, C3.2, C8.1, R2.2, R7.2, R8.1, U1.4 (VS), U1.16 (VPU), U2.8 (+Vs)
+BATT: B1.1, B1.2, J1.1, R1.2, R15.1, R16.1, R17.1, R18.1
/BATT_Sense: J2.1, R3.2, R18.2
/Deploy: B1.3, R22.1
/Deploy_Sense+: J1.2, R6.2, R19.1
/Deploy_Sense-: Q1.5 (D), Q1.6 (D), Q1.7 (D), Q1.8 (D), R5.2, R19.2
/Heater: B1.4, R23.1
/Heater_Sense+: R13.2, R15.2, R16.2, R17.2, R20.1
/Heater_Sense-: Q2.5 (D), Q2.6 (D), Q2.7 (D), Q2.8 (D), R9.2, R20.2
/I2C2_SCL: B1.6, R12.1, U1.6 (SCL), U2.2 (SCL)
/I2C2_SDA: B1.5, U1.7 (SDA), U2.1 (SDA)
/NTC: B1.10, TH1.1
GND: B1.9, B1.11, B1.12, C1.1, C3.1, C6.2, C8.2, Q1.1 (S), Q1.2 (S), Q1.3 (S), Q2.1 (S), Q2.2 (S), Q2.3 (S), Q4.1 (S), Q4.2 (S), Q4.3 (S), R4.2, R11.2, R24.2, R25.2, R27.1, TH1.2, U1.3 (GND), U1.17 (EP), U2.4 (GND), U2.5 (A2)
unnamed: J2.2, J3.1 (Pin_1_1), J4.1 (Pin_1_1), R21.1
unnamed: J5.1 (Pin_1_1), J6.1 (Pin_1_1), J7.1 (Pin_1_1), J8.1 (Pin_1_1), R26.1
unnamed: C7.2, J9.1 (Pin_1_1), J10.1 (Pin_1_1), Q3.1 (S), Q3.2 (S), Q3.3 (S), U3.6 (VSS)
unnamed: Q1.4 (G), R22.2, R24.1
unnamed: Q2.4 (G), R23.2, R25.1
unnamed: Q3.5 (D), Q3.6 (D), Q3.7 (D), Q3.8 (D), Q4.5 (D), Q4.6 (D), Q4.7 (D), Q4.8 (D)
unnamed: Q3.4 (G), U3.1 (OD)
unnamed: Q4.4 (G), U3.2 (OC)
unnamed: R8.2, R12.2, U1.5 (A0)
unnamed: C2.1, R1.1, U1.12 (IN+1)
unnamed: C4.1, R5.1, U1.15 (IN+2)
unnamed: C5.1, R9.1, U1.2 (IN+3)
unnamed: C2.2, R3.1, U1.11 (IN-1)
unnamed: C4.2, R6.1, U1.14 (IN-2)
unnamed: C5.2, R13.1, U1.1 (IN-3)
unnamed: R2.1, R4.1, U2.7 (A0)
unnamed: R7.1, R11.1, U2.6 (A1)
unnamed: R27.2, U3.3 (CS)
unnamed: C7.1, R26.2, U3.4 (VC)
unnamed: C6.1, R21.2, U3.5 (VDD)

Notes on the sheet:
Heater
I/V Monitor

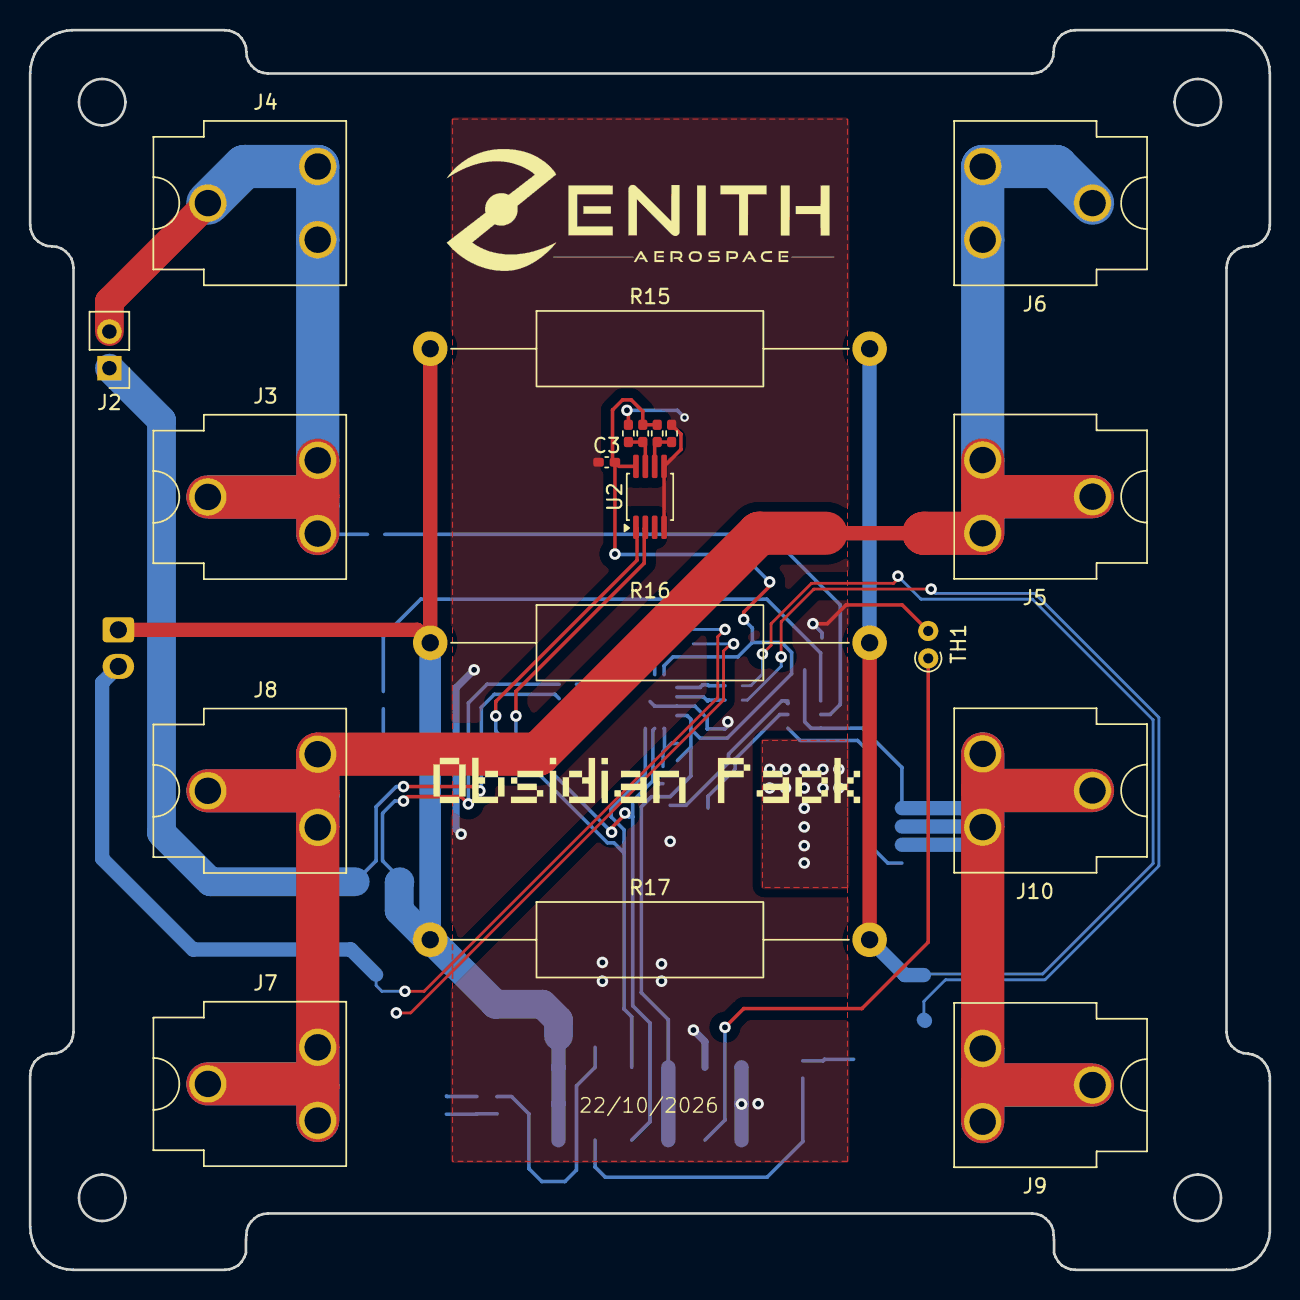
[picture p14: board PCB Bateria 09082026.kicad_pcb from above]

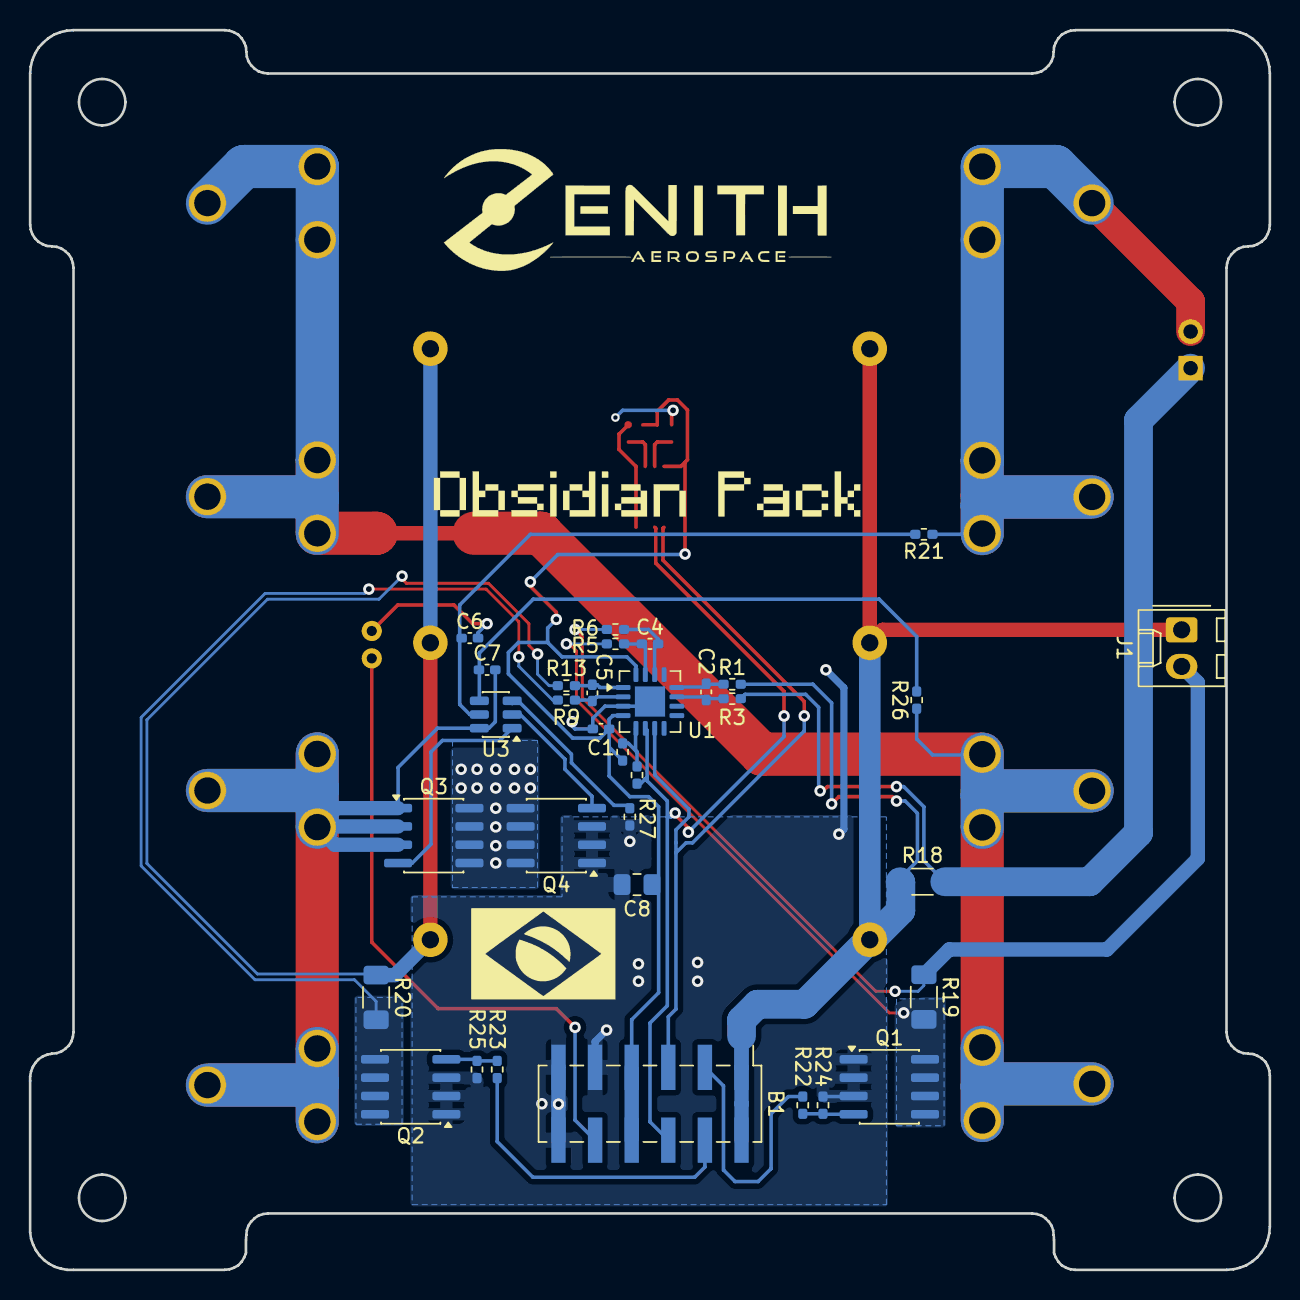
[picture p15: board PCB Bateria 09082026.kicad_pcb from below]

Board: 4 copper layers, 86.0 x 86.0 mm, 52 parts (33 on the bottom side), 33 nets.
