zenitheesc/ZenSat-V3-EPS/Power Supply/Kicad/Power Supply ZensatV3.kicad_pcb

## KiCad design Power Supply/Kicad/Power Supply ZensatV3.kicad_pcb (2026-07-06, an earlier design)

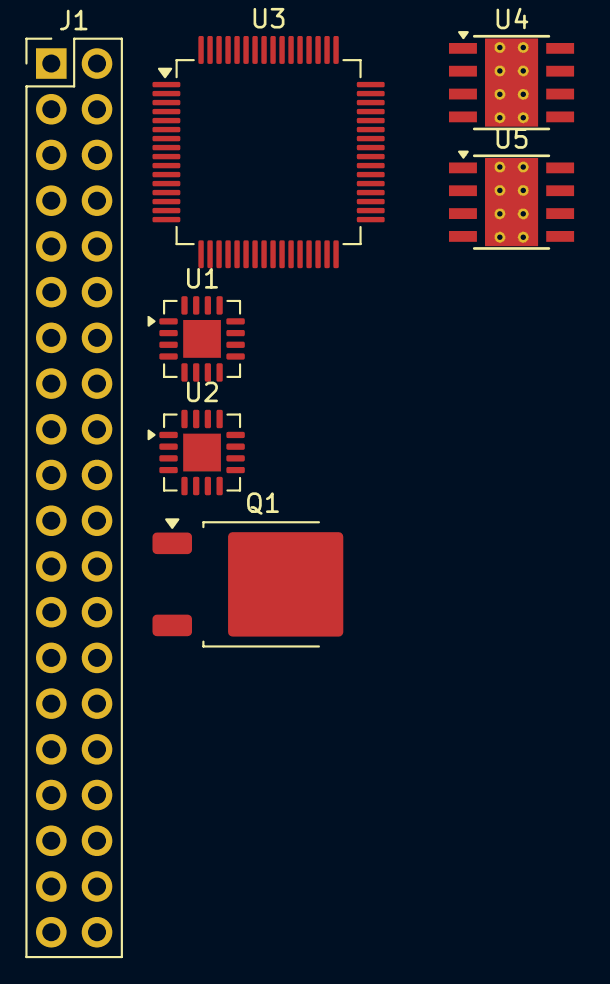
[picture p16: board Power Supply/Kicad/Power Supply ZensatV3.kicad_pcb from above]

Board: 2 copper layers, 7 parts (0 on the bottom side), 6 nets, no tracks yet.

Parts:
J1: ZenBus; PinHeader_2x20_P2.54mm_Vertical
Q1: QM6006D; TO-252-2
U1, U2: INA3221; Texas_RGV0016A_VQFN-16-1EP_4x4mm_P0.65mm_EP2.1x2.1mm
U3: STM32L476RGTx; LQFP-64_10x10mm_P0.5mm
U4, U5: LMR33640DDDA; Texas_HSOP-8-1EP_3.9x4.9mm_P1.27mm_ThermalVias

Connections:
/3V3: J1.11, J1.12
/5V: J1.9, J1.10
/BAT+: J1.5, J1.6
GND: J1.1, J1.2, J1.3, J1.4, U1.3 (GND_3), U2.3 (GND_3), U3.12 (VSSA), U3.18 (VSS), U3.31 (VSS), U3.47 (VSS), U3.63 (VSS)
unnamed: U4.1 (GND), U4.9 (GND)
unnamed: U5.1 (GND), U5.9 (GND)
