zenitheesc/ZenSat-V3-EPS/Teste32G031/Core/Src/main.c

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
/* Includes ------------------------------------------------------------------*/
#include "main.h"

/* USER CODE BEGIN Includes */
#include "platform/platform.h"
#include <stdio.h>
#include "INA3221.h"
/* USER CODE END Includes */

I2C_HandleTypeDef hi2c1;

UART_HandleTypeDef hlpuart1;

TIM_HandleTypeDef htim2;

void SystemClock_Config(void);
static void MX_GPIO_Init(void);
static void MX_I2C1_Init(void);
static void MX_LPUART1_UART_Init(void);
static void MX_TIM2_Init(void);
/* USER CODE BEGIN PFP */
void I2C_Recover_Bus(void);
/* USER CODE END PFP */

/* USER CODE BEGIN 0 */
#ifdef __GNUC__

/* With GCC/RAISONANCE, small printf (option LD Linker->Libraries->Small printf
 set to 'Yes') calls __io_putchar() */
#define PUTCHAR_PROTOTYPE int __io_putchar(int ch)
#else
#define PUTCHAR_PROTOTYPE int fputc(int ch, FILE *f)
#endif /* __GNUC__ */

PUTCHAR_PROTOTYPE
{
 HAL_UART_Transmit(&hlpuart1, (uint8_t *)&ch, 1, 0xFFFF);
 return ch;
}
/* USER CODE END 0 */

/**
  * @brief  The application entry point.
  * @retval int
  */
int main(void)
{

  /* MCU Configuration--------------------------------------------------------*/

  /* Reset of all peripherals, Initializes the Flash interface and the Systick. */
  HAL_Init();

  /* Configure the system clock */
  SystemClock_Config();

  /* Initialize all configured peripherals */
  MX_GPIO_Init();
  MX_I2C1_Init();
  MX_LPUART1_UART_Init();
  MX_TIM2_Init();
  /* USER CODE BEGIN 2 */

  // ***************CONFIGURAÇÃO DO INA3221****************
  // 1. Configura a estrutura principal do sensor
    ina3221_t meu_sensor = {
        .device = { .i2c = &hi2c1, .address = 0x40 }, // Endereço padrão

        // 2. Preenche as configurações baseadas no struct do .h
        .config = {
            .ch1 = true,
            .ch2 = true,
            .ch3 = true,
            .avg_mode = 3,      // Exemplo: 3 (64 samples, confira o datasheet)
            .v_bus_ct = 4,      // Tempo de conversão (ex: 1.1ms)
            .v_sh_ct = 4,
            .op_mode = 7,       // Continuous Shunt and Bus

            // IMPORTANTE: Coloque o valor exato dos resistores soldados na sua placa!
            // Geralmente módulos INA3221 usam resistores de 0.1 ohm (R100)
            .ch1_resistor = 0.1f,
            .ch2_resistor = 0.1f,
            .ch3_resistor = 0.1f
        }
    };

    // 3. Inicializa (testa se o sensor está vivo e dá reset)
    if (ina3221_init(meu_sensor) != 0) {
        printf("Erro: Sensor nao encontrado!\r\n");
    }

    // 4. Aplica as configurações que definimos acima
    ina3221_config(meu_sensor);

    // 5. Cria a struct vazia que vai receber as medições
    ina3221_values_t leituras = {0};
  // ***************CONFIGURAÇÃO DO PWM****************

  pwm_t ledp = {.handle = &htim2, .channel = TIM_CHANNEL_3, .bits = 8};


  uint8_t dutyc = 0;

  pwm_start(ledp);
  /* USER CODE END 2 */

  /* Infinite loop */
  /* USER CODE BEGIN WHILE */
  while (1)
  {
	  // 1. Atualiza todos os valores chamando a função da sua biblioteca
	        error_t status = ina3221_mensurement(meu_sensor, &leituras);
	        // 2. Verificamos se houve erro de comunicação (status diferente de 0)
	              if (status != 0) {
	                  printf("\r\n[ALERTA] Comunicacao perdida com o INA3221!\r\n");
	                  printf("Tentando reiniciar o sensor...\r\n");

	                  I2C_Recover_Bus();

	                  // Tenta fazer o processo de inicialização de novo
	                  if (ina3221_init(meu_sensor) == 0) {
	                      // Se o init deu certo, manda as configurações novamente
	                      ina3221_config(meu_sensor);
	                      printf("[SUCESSO] Sensor reiniciado e reconfigurado!\r\n\n");
	                  } else {
	                      printf("[FALHA] Sensor continua offline. Verifique os fios!\r\n\n");
	                  }

	                  // Aguarda 2 segundos antes de tentar de novo para não travar o terminal com mensagens
	                  delay_ms(2000);

	                  // O comando 'continue' faz o código pular todo o resto do loop
	                  // e voltar imediatamente para o topo do 'while(1)'
	                  continue;
	              }

	        // 2. Extrai e converte os dados do CANAL 1
	        int ch1_tensao_mv   = (int)(leituras.ch1_bus_v * 1000.0f);
	        int ch1_corrente_ma = (int)(leituras.ch1_current * 1000.0f);
	        int ch1_potencia_mw = (int)(leituras.ch1_pot * 1000.0f);

	        // 3. Extrai e converte os dados do CANAL 2
	        int ch2_tensao_mv   = (int)(leituras.ch2_bus_v * 1000.0f);
	        int ch2_corrente_ma = (int)(leituras.ch2_current * 1000.0f);
	        int ch2_potencia_mw = (int)(leituras.ch2_pot * 1000.0f);

	        // 4. Extrai e converte os dados do CANAL 3
	        int ch3_tensao_mv   = (int)(leituras.ch3_bus_v * 1000.0f);
	        int ch3_corrente_ma = (int)(leituras.ch3_current * 1000.0f);
	        int ch3_potencia_mw = (int)(leituras.ch3_pot * 1000.0f);

	        // 5. Imprime tudo formatado no terminal serial
	        printf("======= LEITURAS INA3221 =======\r\n");
	        printf("CH1 -> Tensao: %5d mV | Corrente: %5d mA | Potencia: %5d mW\r\n", ch1_tensao_mv, ch1_corrente_ma, ch1_potencia_mw);
	        printf("CH2 -> Tensao: %5d mV | Corrente: %5d mA | Potencia: %5d mW\r\n", ch2_tensao_mv, ch2_corrente_ma, ch2_potencia_mw);
	        printf("CH3 -> Tensao: %5d mV | Corrente: %5d mA | Potencia: %5d mW\r\n", ch3_tensao_mv, ch3_corrente_ma, ch3_potencia_mw);
	        printf("================================\r\n\n");

	        // 6. Aguarda 2 segundos antes de atualizar a tela novamente
	        delay_ms(2000);
    /* USER CODE END WHILE */

    /* USER CODE BEGIN 3 */
  }
  /* USER CODE END 3 */
}

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
/* USER CODE BEGIN 4 */

// *********************************** REINICIO DO I2C DO STM ************************************

void I2C_Recover_Bus(void)
{
    // 1. Avisa a biblioteca HAL para "esquecer" o estado atual do I2C
    HAL_I2C_DeInit(&hi2c1);

    // 2. Força um reset físico no hardware do periférico I2C1 usando os registradores de clock (RCC)
    __HAL_RCC_I2C1_FORCE_RESET();
    __HAL_RCC_I2C1_RELEASE_RESET();

    // 3. Chama a função gerada pelo próprio CubeIDE para reconfigurar os pinos, velocidade e filtros
    MX_I2C1_Init();
}


/* USER CODE END 4 */
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
