zenitheesc/ZenSat-V3-EPS/Teste32G031/Teste32G031.ioc

Mcu.UserName=STM32G031K8Tx
PA2.Signal=LPUART1_TX
PA3.Signal=LPUART1_RX
PA9.Signal=I2C1_SCL
PB9.Signal=I2C1_SDA
PC6.Signal=S_TIM2_CH3
