zenitheesc/ZenSat-V3-EPS/(commit log)

2026-07-06 commit de teste com o git, adicionado sim. Ltspice
2026-07-13 Reorganize KiCAD project structure
    Move Power Supply KiCAD design files to Main Board folder and consolidate simulations directory. This reorganizes the project hierarchy to co-locate related design files under the Main Board folder structure.
2026-07-13 adição testes stm32
2026-07-19 Atualização do circuito/pcb
2026-07-21 atualização pcb
2026-07-24 atualização esquema e pcb
2026-08-13 atualização pcb/esquema
2026-08-20 Adição pcb baterias
2026-10-08 Main Board V1.0
    Conclusão da Main Board.
