zenitheesc/ZenSat-V3-EPS/(notices)

Notices in the files:
Teste32G031/Core/Src/main.c:
Copyright (c) 2026 STMicroelectronics.
All rights reserved.
This software is licensed under terms that can be found in the LICENSE file
